eleanorfitzsimons/Smart-Plant-Monitoring-System/Pins.h

#ifndef PINS_H
#define PINS_H

#include <Arduino.h>

/********* pressure sensors ********/
const int PRESSURE1 = A1;
const int PRESSURE2 = A2;
const int PRESSURE3 = A3;
const int PRESSURE4 = A4;

/*********** servo motor *********/
const int MOTOR = 9;

#endif
